seventhsu/pfc-drsstc/README.md

# pfc-drsstc
A DRSSTC with a boost-type PFC front end, all on a single circuit board.
