seventhsu/pfc-drsstc/pfc-drsstc.kicad_pcb

## KiCad design pfc-drsstc.kicad_pcb (2025-04-19)

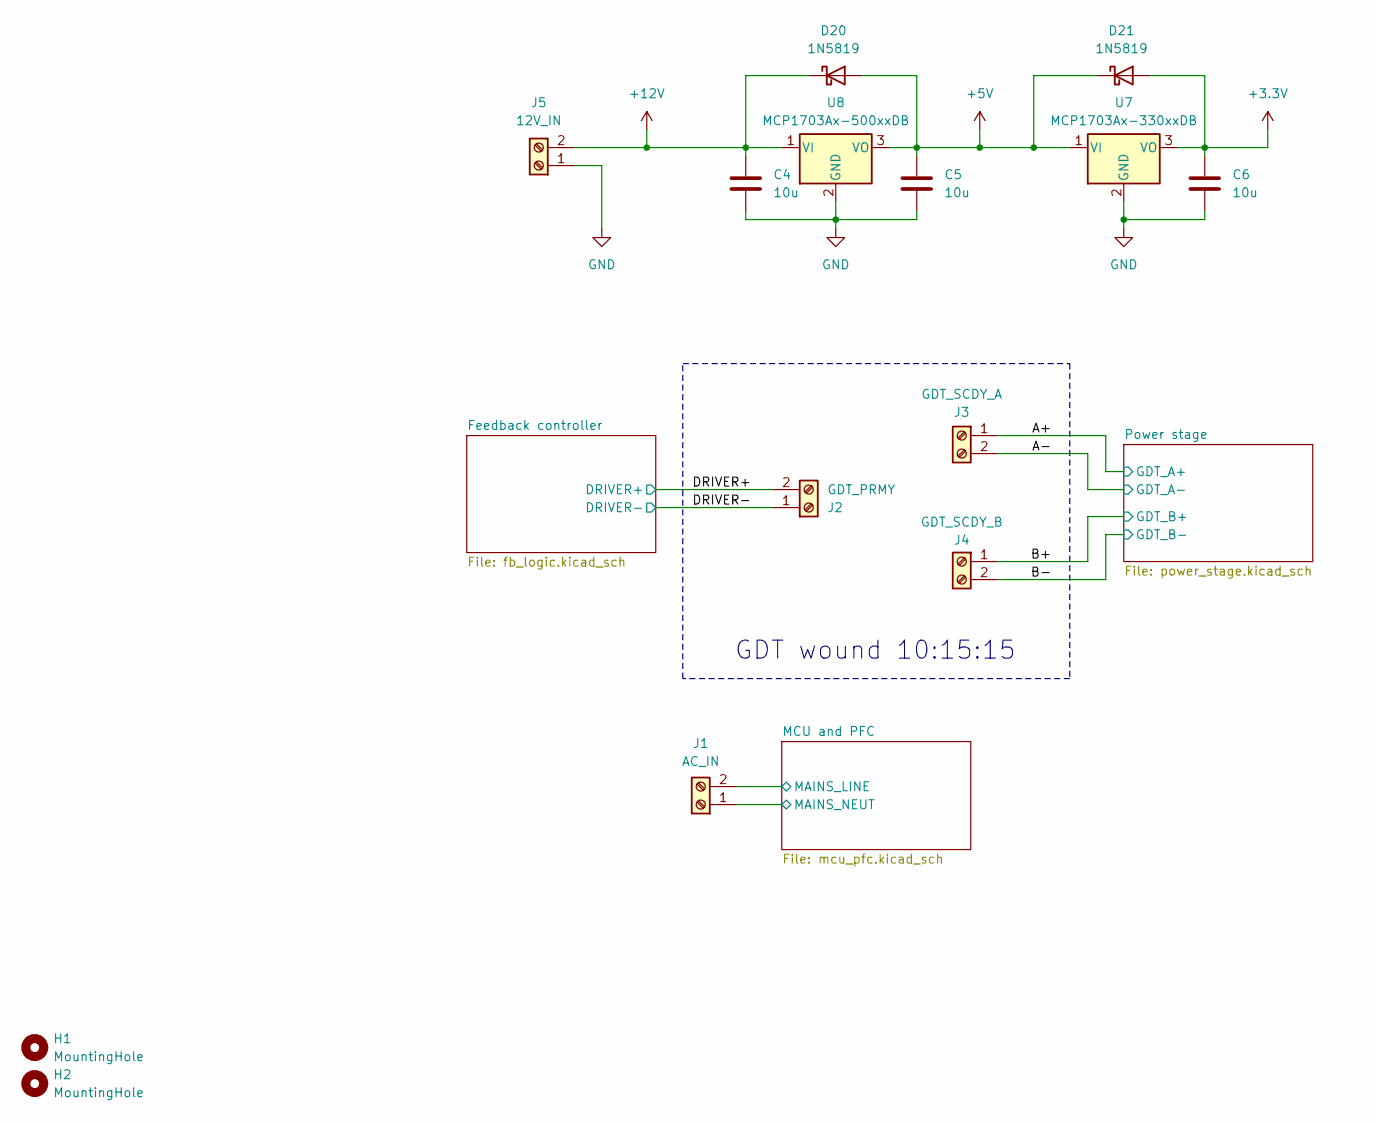
[picture p1: schematic pfc-drsstc.kicad_sch]

Parts:
C4, C5, C6: 10u; C_0805_2012Metric
D20, D21: 1N5819; D_DO-41_SOD81_P2.54mm_Vertical_AnodeUp
H1, H2: MountingHole; MountingHole_3.2mm_M3
J1: AC_IN; TerminalBlock_Phoenix_MKDS-1,5-2_1x02_P5.00mm_Horizontal
J2: GDT_PRMY; TerminalBlock_Phoenix_MKDS-1,5-2_1x02_P5.00mm_Horizontal
J3: GDT_SCDY_A; TerminalBlock_Phoenix_MKDS-1,5-2_1x02_P5.00mm_Horizontal
J4: GDT_SCDY_B; TerminalBlock_Phoenix_MKDS-1,5-2_1x02_P5.00mm_Horizontal
J5: 12V_IN; TerminalBlock_Phoenix_MKDS-1,5-2_1x02_P5.00mm_Horizontal
U7: MCP1703Ax-330xxDB; SOT-223-3_TabPin2
U8: MCP1703Ax-500xxDB; SOT-223-3_TabPin2

Connections:
+3.3V: C6.1, D21.2 (A), U7.3 (VO); also elsewhere on the board
+5V: C5.1, D20.2 (A), D21.1 (K), U7.1 (VI), U8.3 (VO); also elsewhere on the board
+12V: C4.1, D20.1 (K), J5.2, U8.1 (VI); also elsewhere on the board
/A+: J3.1; also elsewhere on the board
/A-: J3.2; also elsewhere on the board
/B+: J4.1; also elsewhere on the board
/DRIVER+: J2.2; also elsewhere on the board
/DRIVER-: J2.1; also elsewhere on the board
/MCU and PFC/MAINS_LINE: J1.2; also elsewhere on the board
/MCU and PFC/MAINS_NEUT: J1.1; also elsewhere on the board
GND: C4.2, C5.2, C6.2, J4.2, J5.1, U7.2 (GND), U8.2 (GND); also elsewhere on the board

Notes on the sheet:
GDT wound 10:15:15

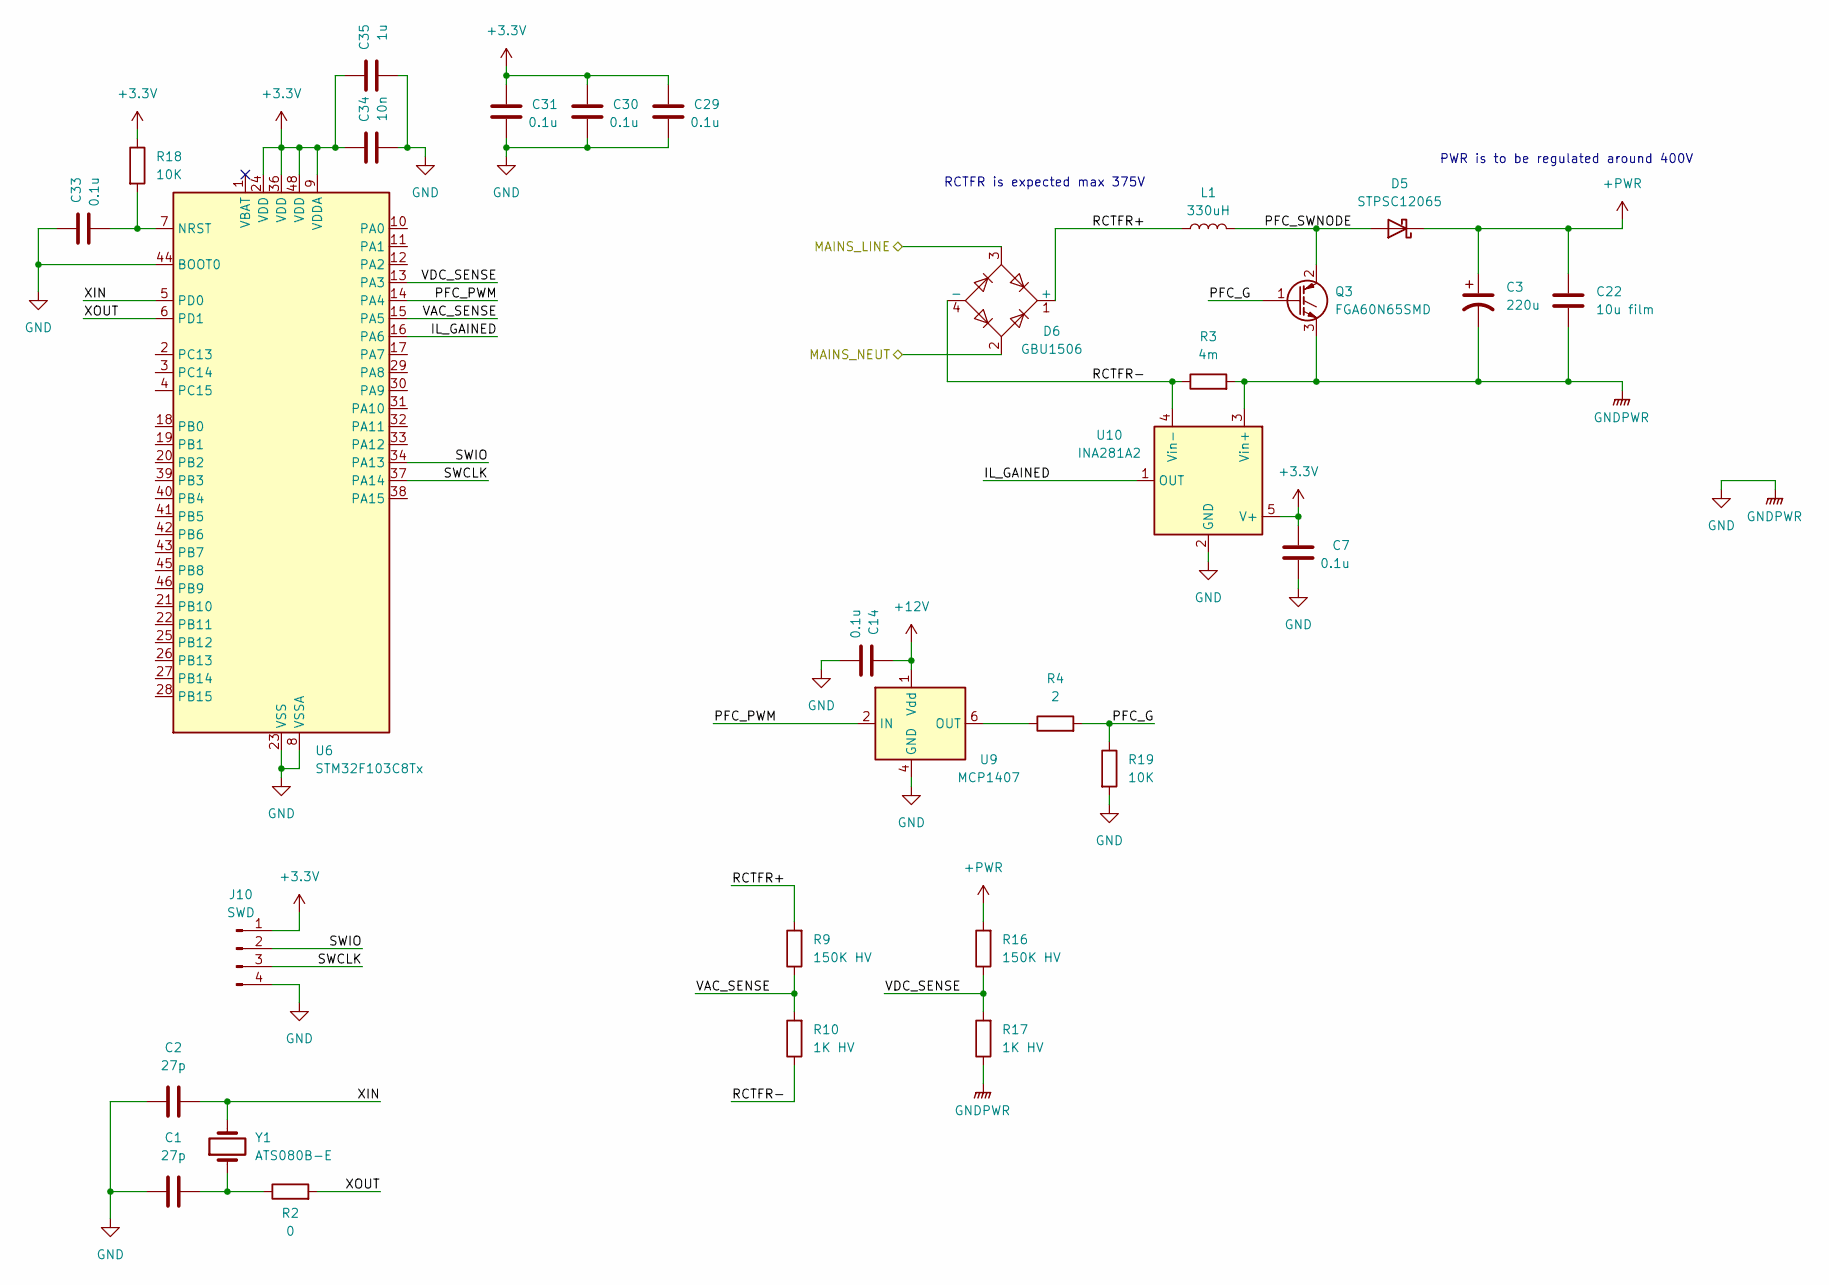
[picture p2: schematic mcu_pfc.kicad_sch]

Parts:
C1, C2: 27p; C_0805_2012Metric
C3: 220u; CP_Radial_D35.0mm_P10.00mm_SnapIn
C7, C14, C29, C30, C31, C33: 0.1u; C_0805_2012Metric
C22: 10u film; C_Rect_L31.5mm_W15.0mm_P27.50mm_MKS4
C34: 10n; C_0805_2012Metric
C35: 1u; C_0805_2012Metric
D5: STPSC12065; TO-220-2_Vertical
D6: GBU1506; Diode_Bridge_Vishay_GBU
J10: SWD; PinHeader_1x04_P2.54mm_Vertical
L1: 330uH; TerminalBlock_Phoenix_MKDS-1,5-2_1x02_P5.00mm_Horizontal
Q3: FGA60N65SMD; TO-3P-3_Vertical
R2: 0; R_0805_2012Metric
R3: 4m; R_2512_6332Metric
R4: 2; R_0805_2012Metric
R9, R16: 150K HV; R_1206_3216Metric
R10, R17: 1K HV; R_1206_3216Metric
R18, R19: 10K; R_0805_2012Metric
U6: STM32F103C8Tx; LQFP-48_7x7mm_P0.5mm
U9: MCP1407; SOIC-8_3.9x4.9mm_P1.27mm
U10: INA281A2; SOT-23-5
Y1: ATS080B-E; Crystal_HC49-4H_Vertical

Connections:
+3.3V: C7.2, C29.2, C30.2, C31.2, C34.2, C35.2, J10.1, R18.1, U6.9 (VDDA), U6.24 (VDD), U6.36 (VDD), U6.48 (VDD), U10.5 (V+); also elsewhere on the board
+12V: C14.2, U9.1 (Vdd), U9.8 (Vdd); also elsewhere on the board
+PWR: C3.1, C22.1, D5.1 (K), R16.2; also elsewhere on the board
/MCU and PFC/IL_GAINED: U6.16 (PA6), U10.1 (OUT)
/MCU and PFC/MAINS_LINE: D6.3; also elsewhere on the board
/MCU and PFC/MAINS_NEUT: D6.2; also elsewhere on the board
/MCU and PFC/PFC_G: Q3.1 (G), R4.2, R19.1
/MCU and PFC/PFC_PWM: U6.14 (PA4), U9.2 (IN)
/MCU and PFC/PFC_SWNODE: D5.2 (A), L1.1, Q3.2 (C)
/MCU and PFC/RCTFR+: D6.1 (+), L1.2, R9.2
/MCU and PFC/RCTFR-: D6.4 (-), R3.1, R10.1, U10.4 (Vin-)
/MCU and PFC/SWCLK: J10.3, U6.37 (PA14)
/MCU and PFC/SWIO: J10.2, U6.34 (PA13)
/MCU and PFC/VAC_SENSE: R9.1, R10.2, U6.15 (PA5)
/MCU and PFC/VDC_SENSE: R16.1, R17.2, U6.13 (PA3)
/MCU and PFC/XIN: C2.2, U6.5 (PD0), Y1.2
/MCU and PFC/XOUT: R2.2, U6.6 (PD1)
GND: C1.1, C2.1, C3.2, C7.1, C14.1, C22.2, C29.1, C30.1, C31.1, C33.2, C34.1, C35.1, J10.4, Q3.3 (E), R3.2, R17.1, R19.2, U6.8 (VSSA), U6.23 (VSS), U6.35 (VSS), U6.44 (BOOT0), U6.47 (VSS), U9.4 (GND), U9.5 (GND), U10.2 (GND), U10.3 (Vin+); also elsewhere on the board
unnamed: C1.2, R2.1, Y1.1
unnamed: R4.1, U9.6 (OUT), U9.7 (OUT)
unnamed: C33.1, R18.2, U6.7 (NRST)

Notes on the sheet:
RCTFR is expected max 375V
PWR is to be regulated around 400V

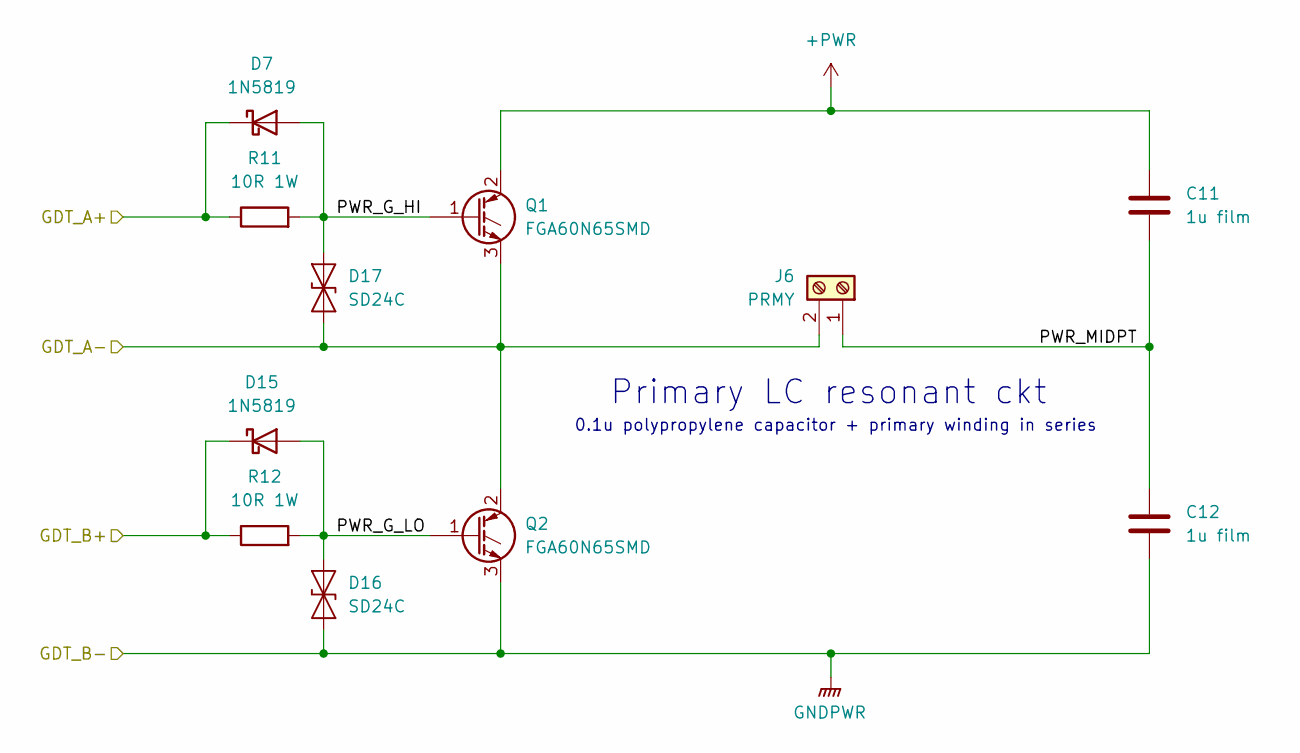
[picture p3: schematic power_stage.kicad_sch]

Parts:
C11, C12: 1u film; C_Rect_L26.5mm_W10.5mm_P22.50mm_MKS4
D7, D15: 1N5819; D_DO-41_SOD81_P2.54mm_Vertical_AnodeUp
D16, D17: SD24C; D_SOD-323
J6: PRMY; TerminalBlock_Phoenix_MKDS-1,5-2_1x02_P5.00mm_Horizontal
Q1, Q2: FGA60N65SMD; TO-3P-3_Vertical
R11, R12: 10R 1W; R_2512_6332Metric

Connections:
+PWR: C11.1, Q1.2 (C); also elsewhere on the board
/A+: D7.1 (K), R11.1; also elsewhere on the board
/A-: D17.1 (A1), J6.2, Q1.3 (E), Q2.2 (C); also elsewhere on the board
/B+: D15.1 (K), R12.1; also elsewhere on the board
/Power stage/PWR_G_HI: D7.2 (A), D17.2 (A2), Q1.1 (G), R11.2
/Power stage/PWR_G_LO: D15.2 (A), D16.2 (A2), Q2.1 (G), R12.2
/Power stage/PWR_MIDPT: C11.2, C12.1, J6.1
GND: C12.2, D16.1 (A1), Q2.3 (E); also elsewhere on the board

Notes on the sheet:
Primary LC resonant ckt
0.1u polypropylene capacitor + primary winding in series

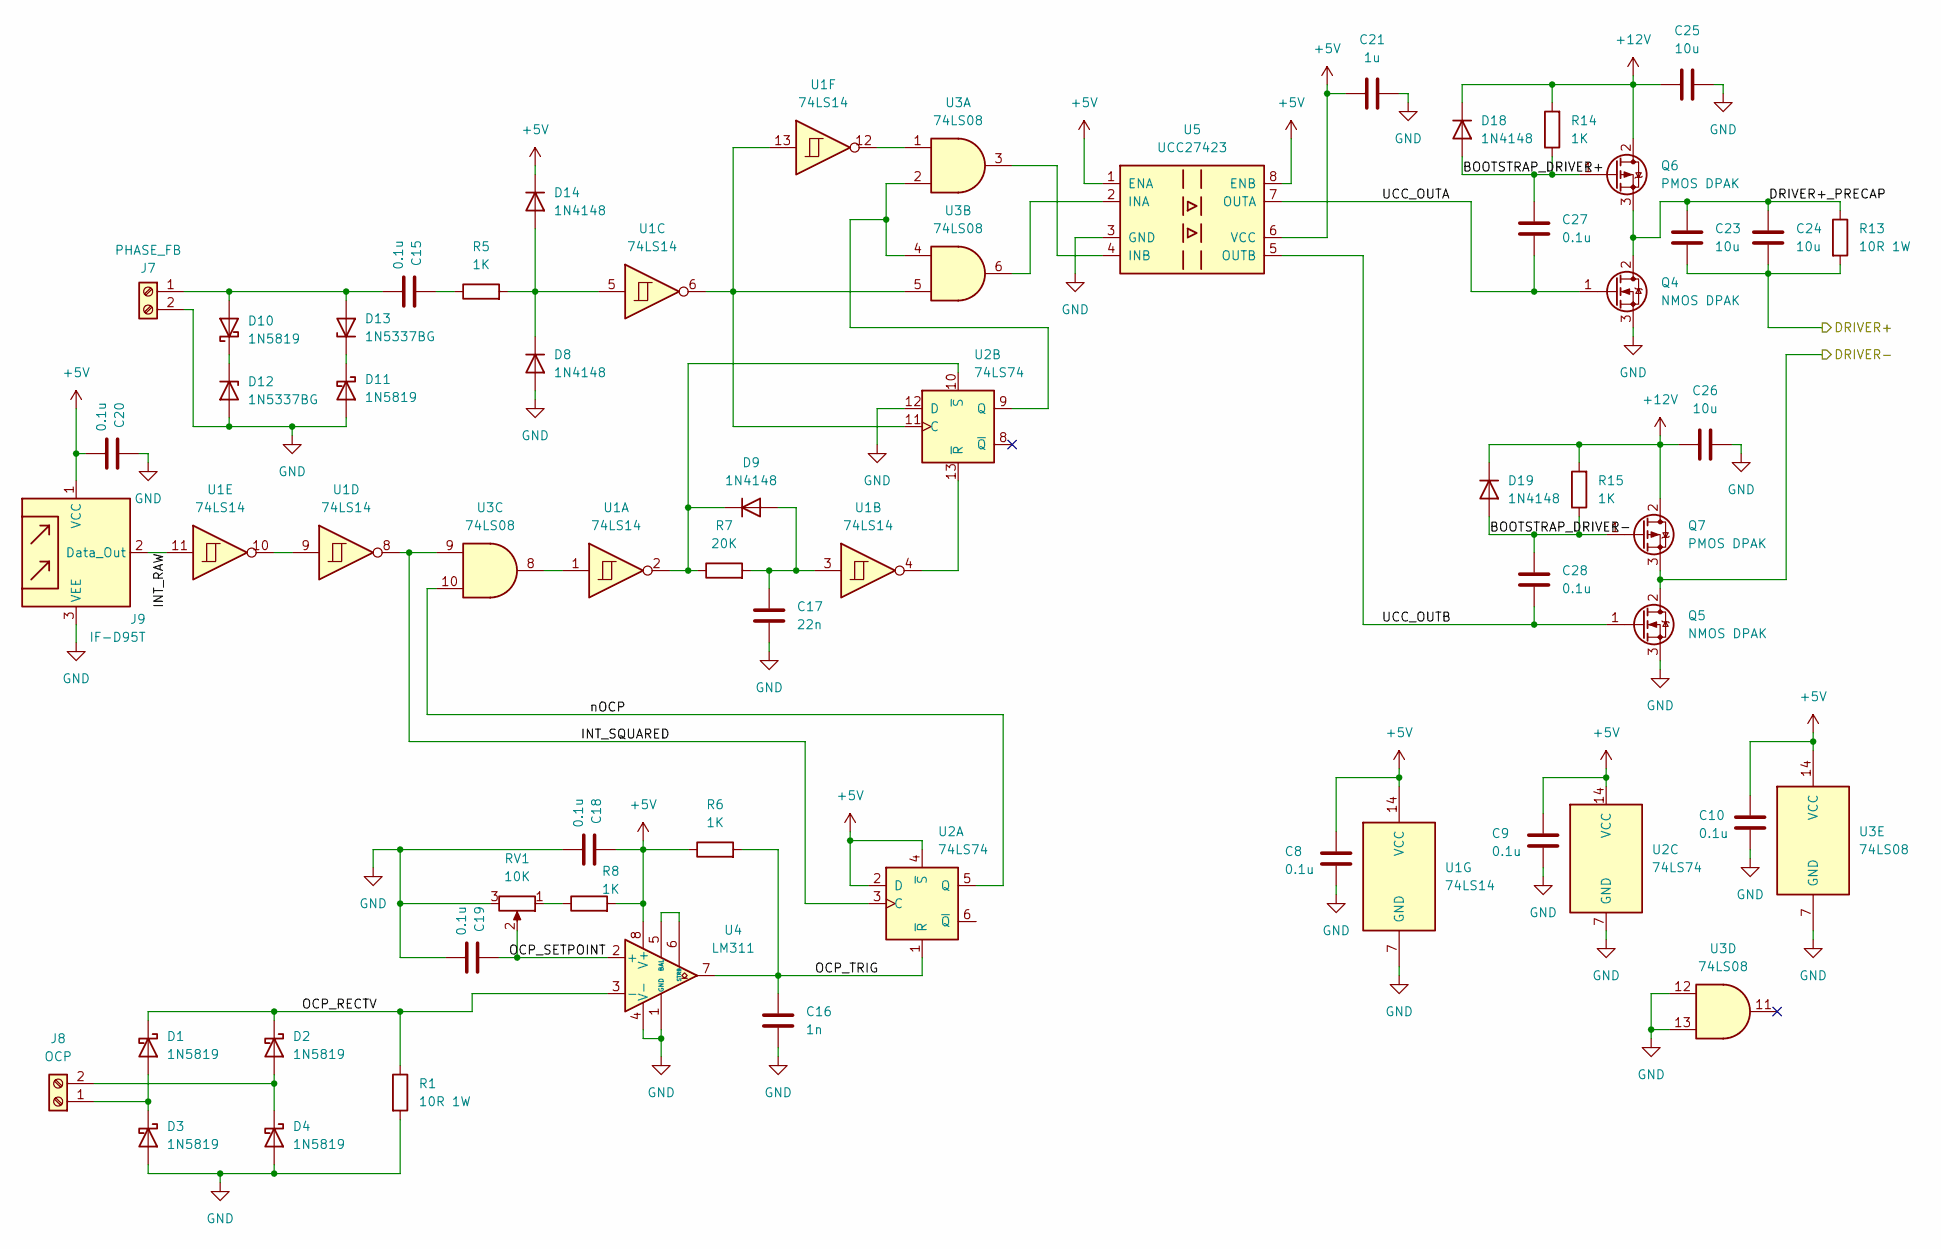
[picture p4: schematic fb_logic.kicad_sch]

Parts:
C8, C9, C10, C15, C18, C19, C20, C27, C28: 0.1u; C_0805_2012Metric
C16: 1n; C_0805_2012Metric
C17: 22n; C_0805_2012Metric
C21: 1u; C_0805_2012Metric
C23, C24, C25, C26: 10u; C_1206_3216Metric
D1, D2, D3, D4, D10, D11: 1N5819; D_DO-41_SOD81_P2.54mm_Vertical_AnodeUp
D8, D9, D14, D18, D19: 1N4148; D_DO-35_SOD27_P2.54mm_Vertical_AnodeUp
D12, D13: 1N5337BG; D_5KPW_P7.62mm_Vertical_AnodeUp
J7: PHASE_FB; TerminalBlock_Phoenix_MKDS-1,5-2_1x02_P5.00mm_Horizontal
J8: OCP; TerminalBlock_Phoenix_MKDS-1,5-2_1x02_P5.00mm_Horizontal
J9: IF-D95T; TO-92_Inline_Wide
Q4, Q5: NMOS DPAK; TO-252-2
Q6, Q7: PMOS DPAK; TO-252-2
R1, R13: 10R 1W; R_2512_6332Metric
R5, R6, R8, R14, R15: 1K; R_0805_2012Metric
R7: 20K; R_0805_2012Metric
RV1: 10K; Potentiometer_Bourns_3386P_Vertical
U1: 74LS14; SOIC-14_3.9x8.7mm_P1.27mm
U2: 74LS74; SOIC-14_3.9x8.7mm_P1.27mm
U3: 74LS08; SOIC-14_3.9x8.7mm_P1.27mm
U4: LM311; SOIC-8_3.9x4.9mm_P1.27mm
U5: UCC27423; SOIC-8_3.9x4.9mm_P1.27mm

Connections:
+5V: C8.2, C9.2, C10.2, C18.2, C20.1, C21.1, D14.1 (K), J9.1 (VCC), R6.1, R8.2, U1.14 (VCC), U2.2 (D), U2.4 (~S), U2.14 (VCC), U3.14 (VCC), U4.8 (V+), U5.1 (ENA), U5.6 (VCC), U5.8 (ENB); also elsewhere on the board
+12V: C25.1, C26.1, D18.1 (K), D19.1 (K), Q6.2 (D), Q7.2 (D), R14.2, R15.2; also elsewhere on the board
/DRIVER+: C23.2, C24.2, R13.2; also elsewhere on the board
/DRIVER-: Q5.2 (D), Q7.3 (S); also elsewhere on the board
/Feedback controller/BOOTSTRAP_DRIVER+: C27.2, D18.2 (A), Q6.1 (G), R14.1
/Feedback controller/BOOTSTRAP_DRIVER-: C28.2, D19.2 (A), Q7.1 (G), R15.1
/Feedback controller/DRIVER+_PRECAP: C23.1, C24.1, Q4.2 (D), Q6.3 (S), R13.1
/Feedback controller/INT_RAW: J9.2 (Data_Out), U1.11
/Feedback controller/INT_SQUARED: U1.8, U2.3 (C), U3.9
/Feedback controller/OCP_RECTV: D1.1 (K), D2.1 (K), R1.1, U4.3 (-)
/Feedback controller/OCP_SETPOINT: C19.2, RV1.2, U4.2 (+)
/Feedback controller/OCP_TRIG: C16.1, R6.2, U2.1 (~R), U4.7
/Feedback controller/UCC_OUTA: C27.1, Q4.1 (G), U5.7 (OUTA)
/Feedback controller/UCC_OUTB: C28.1, Q5.1 (G), U5.5 (OUTB)
/Feedback controller/nOCP: U2.5 (Q), U3.10
GND: C8.1, C9.1, C10.1, C16.2, C17.2, C18.1, C19.1, C20.2, C21.2, C25.2, C26.2, D3.2 (A), D4.2 (A), D8.2 (A), D11.2 (A), D12.2 (A), J7.2, J9.3 (VEE), Q4.3 (S), Q5.3 (S), R1.2, RV1.3, U1.7 (GND), U2.7 (GND), U2.12 (D), U3.7 (GND), U3.12, U3.13, U4.1 (GND), U4.4 (V-), U5.3 (GND); also elsewhere on the board
unnamed: C15.2, R5.1
unnamed: D1.2 (A), D3.1 (K), J8.1
unnamed: D2.2 (A), D4.1 (K), J8.2
unnamed: C17.1, D9.2 (A), R7.2, U1.3
unnamed: D9.1 (K), R7.1, U1.2, U2.10 (~S)
unnamed: C15.1, D10.2 (A), D13.2 (A), J7.1
unnamed: D10.1 (K), D12.1 (K)
unnamed: D11.1 (K), D13.1 (K)
unnamed: D8.1 (K), D14.2 (A), R5.2, U1.5
unnamed: R8.1, RV1.1
unnamed: U1.1, U3.8
unnamed: U1.9, U1.10
unnamed: U1.12, U3.1
unnamed: U1.6, U1.13, U2.11 (C), U3.5
unnamed: U2.9 (Q), U3.2, U3.4
unnamed: U1.4, U2.13 (~R)
unnamed: U4.5 (BAL), U4.6 (STRB)
unnamed: U3.6, U5.2 (INA)
unnamed: U3.3, U5.4 (INB)

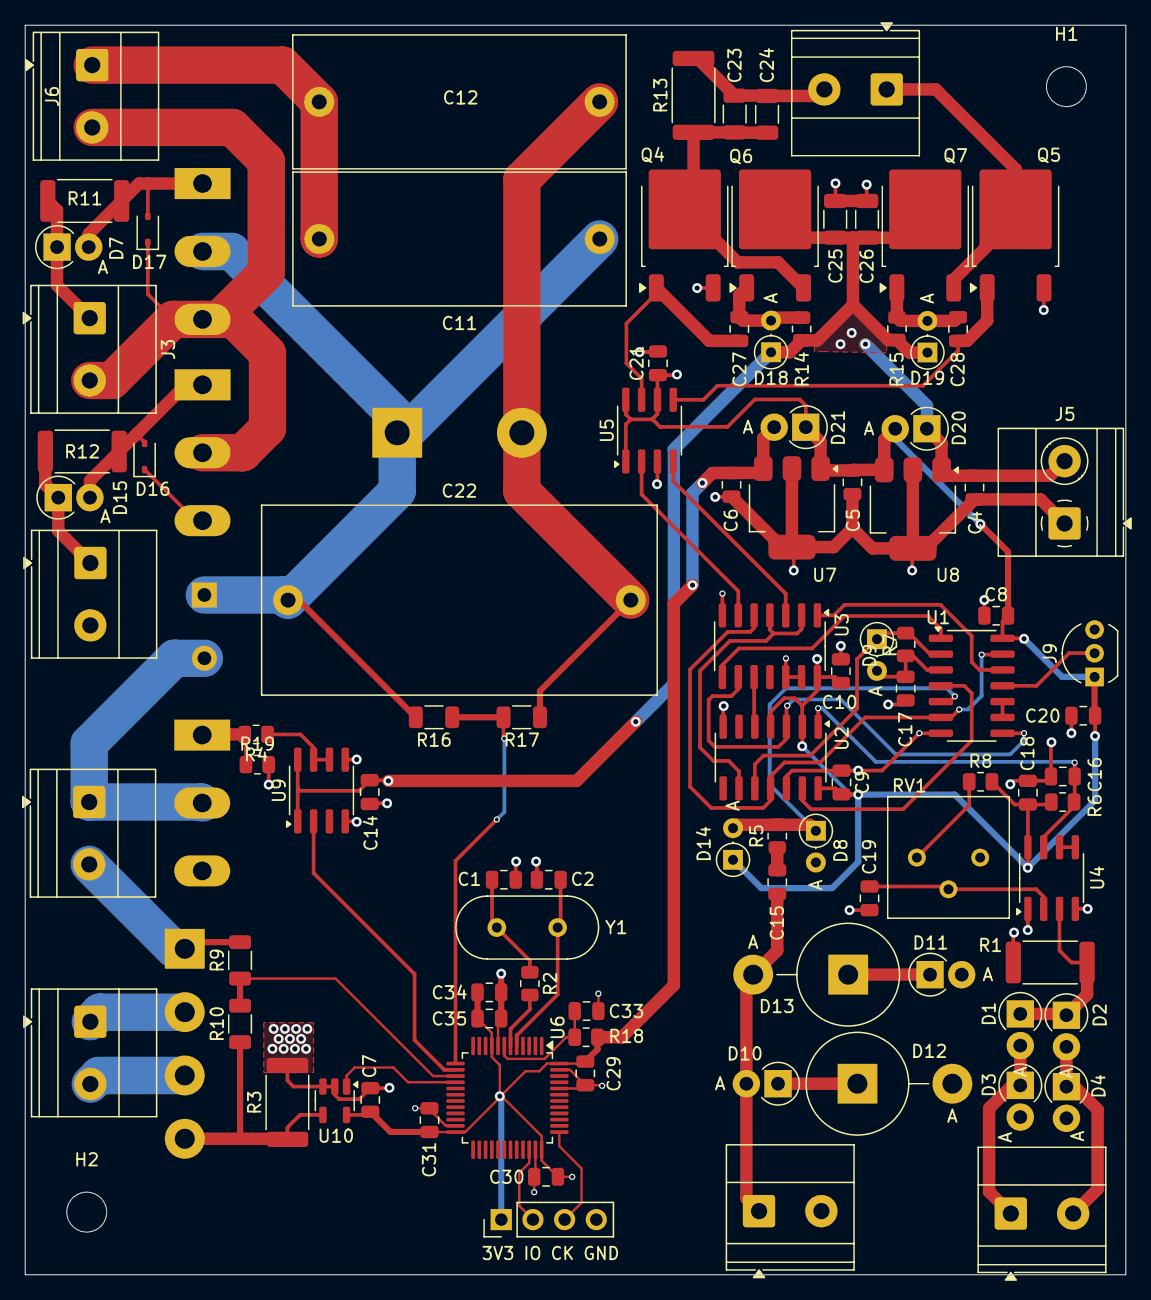
[picture p5: board pfc-drsstc.kicad_pcb from above]

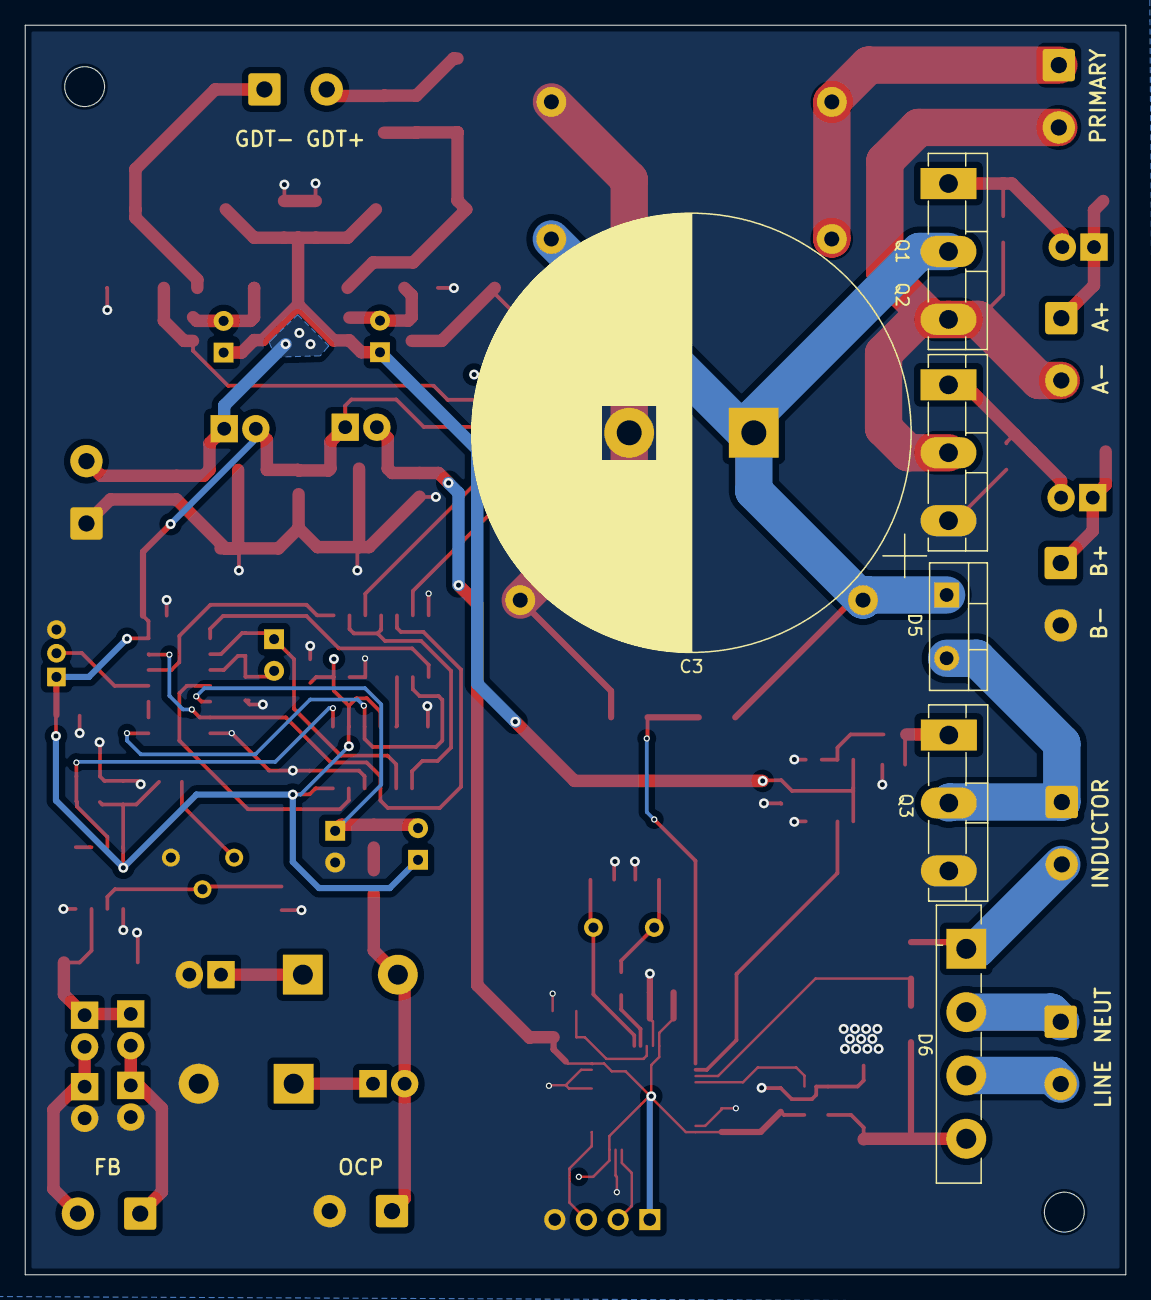
[picture p6: board pfc-drsstc.kicad_pcb from below]

Board: 2 copper layers, 88.3 x 100.2 mm, 105 parts (6 on the bottom side), 60 nets.
