seventhsu/pfc-drsstc/(commit log)

2025-04-07 added progress
    [fb_logic.kicad_sch, mcu_pfc.kicad_sch, pfc-drsstc.kicad_pcb, pfc-drsstc.kicad_sch, power_stage.kicad_sch]
2025-04-10 large amount of work
    [fb_logic.kicad_sch, mcu_pfc.kicad_sch, pfc-drsstc.kicad_pcb, pfc-drsstc.kicad_sch, power_stage.kicad_sch]
2025-04-10 tentative layout completion
    [mcu_pfc.kicad_sch, pfc-drsstc.kicad_pcb, pfc-drsstc.kicad_sch, power_stage.kicad_sch]
2025-04-10 layout nearly complete
    [fb_logic.kicad_sch, mcu_pfc.kicad_sch, pfc-drsstc.kicad_pcb, pfc-drsstc.kicad_sch, power_stage.kicad_sch]
2025-04-19 Completed layout v1
    [mcu_pfc.kicad_sch, pfc-drsstc.kicad_pcb, pfc-drsstc.kicad_sch, power_stage.kicad_sch]
